thammass/uno_Personal_door/1379958241-systemsafe-o.jpg

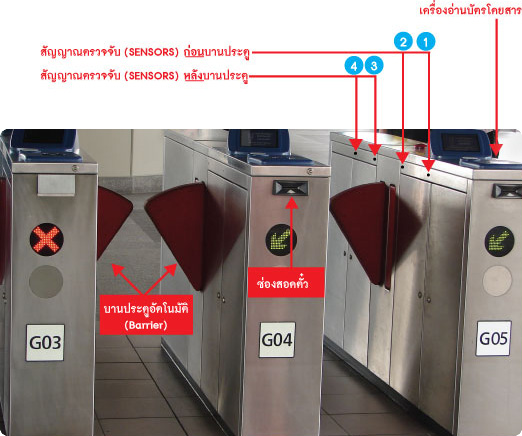
1379958241-systemsafe-o.jpg
