thammass/uno_Personal_door/Feedback_LDR.pptx

ติดตั้งแบบที่1 เจาะรู 3ｍｍ

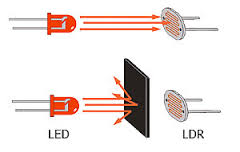
[picture p2: figure]

บานประตู

3mm

0 องศา

180 องศา

Center

การ feed back ตำแหน่งองศาประตู

ติดตั้งแบบที่2 ไม่ต้องเจาะรู

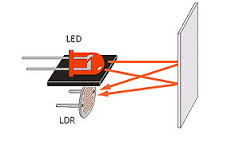
[picture p3: figure]
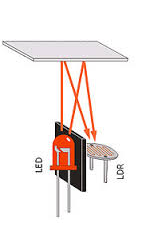
[picture p4: figure]

2015/08/25
