thammass/uno_Personal_door/Feedback_Proximity_degree.pptx

การ feed back ตำแหน่งองศาประตู
ด้วย Proximity Switch

ติดตั้งแนวตั้ง

180 องศา

บานประตู

5mm

0 องศา

ติดตั้งแนวนอน

Center

2015/08/28

## Slide 2

เข้า

ช่องทางเดินที่ 1

ออก

เข้า

ช่องทางเดินที่ 2

ออก

ช่องทางเดินที่ 3

## Slide 3

เข้า

ช่องทางเดินที่ 1

ออก

เข้า

ช่องทางเดินที่ 2

ออก

ช่องทางเดินที่ 3

## Slide 4

รปภ

90 องศา

เข้า

ช่องทางเดินที่ 1

S1

F1

1

S2

F2

0 องศา

S4

0 องศา

ออก

180 องศา

2

180 องศา

เข้า

0 องศา

S3

นอกโรงงาน

90 องศา

ช่องทางเดินที่ 2

90 องศา

F4

3

F3

0 องศา

S6

4

S5

ออก

ช่องทางเดินที่ 3

90 องศา

## วิเคราะห์การหมุน 0 – 90 องศา

TAG

90

0

แก้ไขบานอยู่ไม่ตรง 90 องศา ตอนเริ่มต้น

เปิด: slow จนไม่เจอ TAG -> Feed Step -> Wait

TAG

90

0

ปิด: Feed Step -> slow จนเจอ Tag -> stop
“แก้ปัญหาองศาผิด ขณะ Feed Step เจอ Tag ให้ Stop เลย”

ปรับให้ตรง 90 องศา

## วิเคราะห์การหมุน 90 – 180 องศา

180

90

TAG

แก้ไขบานอยู่ไม่ตรง 90 องศาตอนเริ่มต้น

เปิด: slow จนเจอ TAG -> Feed Step -> Wait

TAG

180

90

ปิด: Feed Step -> slow จนไม่เจอ Tag -> stop
“แก้ปัญหาองศาผิด ขณะ Feed step ไม่เจอ Tag ให้ Stop เลย”

ปรับให้ตรง 90 องศา

## Slide 7

รปภ

90 องศา

1

90

0

2

90

0

180

นอกโรงงาน

3

90

0

180

4

90

0

เข้า

0 องศา

ช่องที่ 1

S1

F1

1

S2

F2

S4

0 องศา

ออก

180 องศา

2

180 องศา

เข้า

0 องศา

S3

90 องศา

ช่องที่ 2

90 องศา

F4

3

F3

0 องศา

S6

4

S5

ออก

ช่องที่ 3

90 องศา

## Slide 8

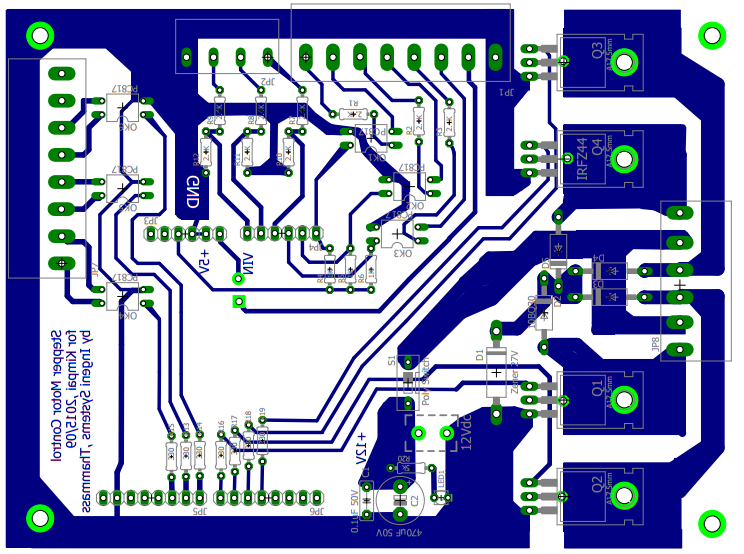
[picture p5: figure]

ลายวงจร จากมุมมอง TOP

## Slide 9

การต่อสาย control ชุด Stepper Motor Control

TAG
+: 24V
- : 0V

DIR(n)
5V:180องศา
0V: 0องศา

OPEN(n)
5V: DIR
0V: 90องศา

ไฟเลี้ยงบอร์ด UNO
5VDC 300mA

ไม่ได้ใช้งาน

+ -

+ -

+ -

+ -

ไม่ได้ใช้งาน

+V

A+

B+

A-

+V

B-

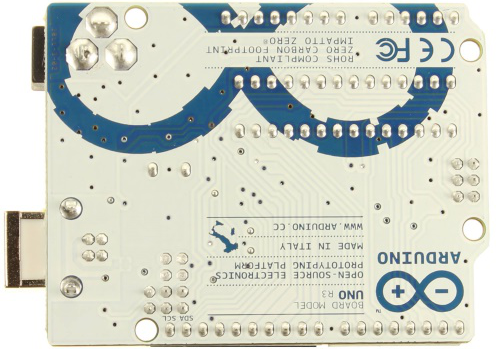
[picture p6: figure]

+ -

Stepper motor
1.8องศา / Step , 3A

M

A+
+V
A-
B+
+V
B-

แสดงสถานะไฟจ่ายให้มอเตอร์

ไฟเลี้ยงเฉพาะมอเตอร์
5V –> 12V ( +V )

Poly Switch 6A
( ตัดไฟเมื่อ Over Load )

## Slide 10

การต่อสาย Sensor Control (Common GND)

Input

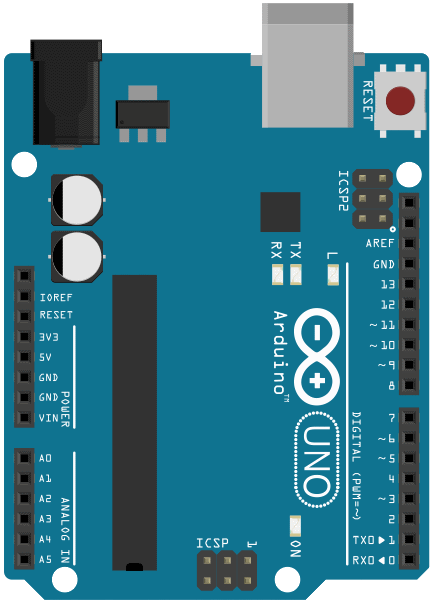
[picture p7: figure]

Output

- Active : ป้อน 0V (Short GND)

5VDC

S6_Echo

S6_Trig

GND

DIR3

DIR2

OPEN4

S4_Echo

S4_Trig

OPEN2

F3

S3_Echo

S3_Trig

F2

S2_Echo

S2_Trig

OPEN1

ไม่ใช้งาน

OPEN3

F4

F1

## Slide 11

F4

F3

F2

F1

System Diagram – สัญญาณควบคุม

S2

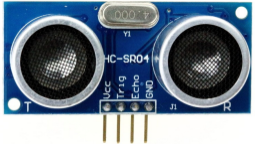
[picture p8: figure]

S3

ไม่ได้ใช้งาน

+ -

+ -

+ -

+ -

ไม่ได้ใช้งาน

+V

A+

B+

A-

+V

B-

+ -

Door1-DIR0

ไม่ได้ใช้งาน

+ -

+ -

+ -

+ -

ไม่ได้ใช้งาน

+V

A+

B+

A-

+V

B-

+ -

Door2-DIR1

ไม่ได้ใช้งาน

+ -

+ -

+ -

+ -

ไม่ได้ใช้งาน

+V

A+

B+

A-

+V

B-

+ -

Door3-DIR1

S4

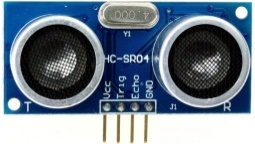
[picture p9: figure]

S6

ไม่ได้ใช้งาน

+ -

+ -

+ -

+ -

ไม่ได้ใช้งาน

+V

A+

B+

A-

+V

B-

+ -

Door2-DIR0

## Slide 12

1. แก้ไขปัญหาการตรวจจับองศาผิด ในกรณีบานเปิด ไปที่ 0 องศา แล้วเจอ tag

องศา
TAG

0

180

90

2. แก้ไขปัญหาการตรวจจับ Center ผิดตำแหน่ง
การตรวจสอบจะทำงานควบคู่กับ Tag องศา
เพื่อกำหนดทิศทางของในการเคลื่อนที่ไปตำแหน่ง
center ที่ถูกต้อง

แบบเดิม

Center
TAG

แบบเดิม

TAG

แบบใหม่

แบบใหม่-1

Center
TAG

แบบใหม่-2

Center
TAG
