thammass/uno_Personal_door/Door_Map-r2.JPG

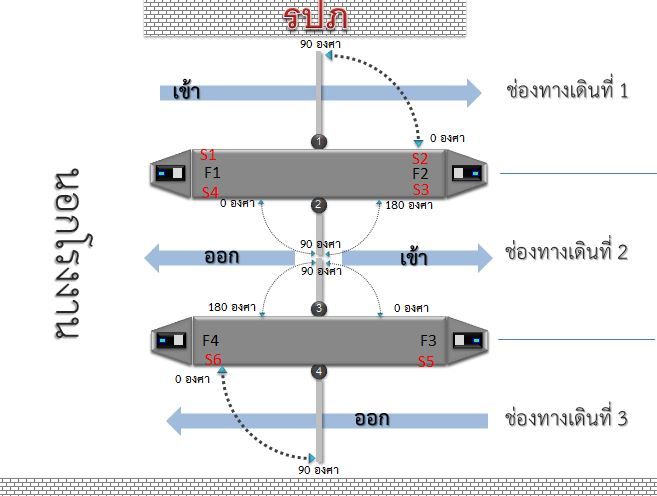
Door_Map-r2.JPG
