thammass/uno_Personal_door/Feedback_Proximity_degree/Slide1.JPG

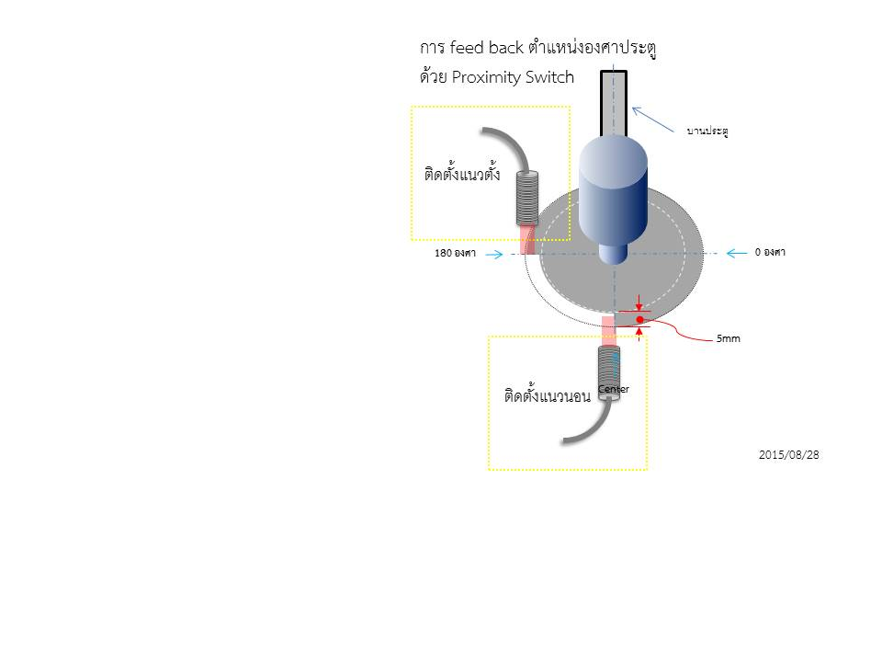
Feedback_Proximity_degree/Slide1.JPG
