thammass/uno_Personal_door/Feedback_Proximity_degree/Slide2.JPG

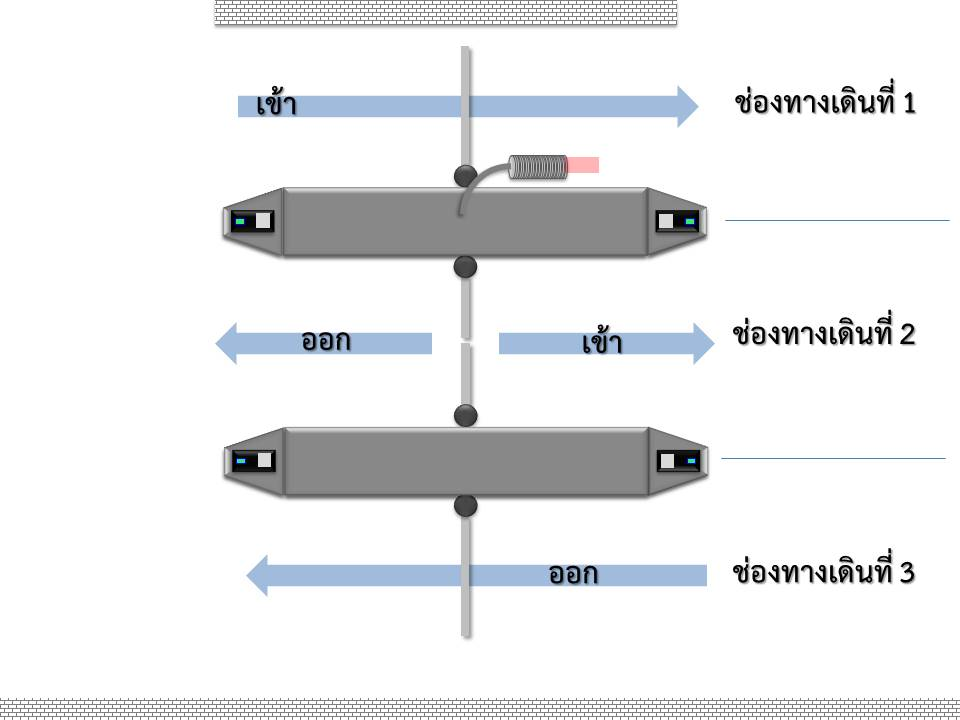
Feedback_Proximity_degree/Slide2.JPG
