thammass/uno_Personal_door/Feedback_Proximity_degree/Slide4.JPG

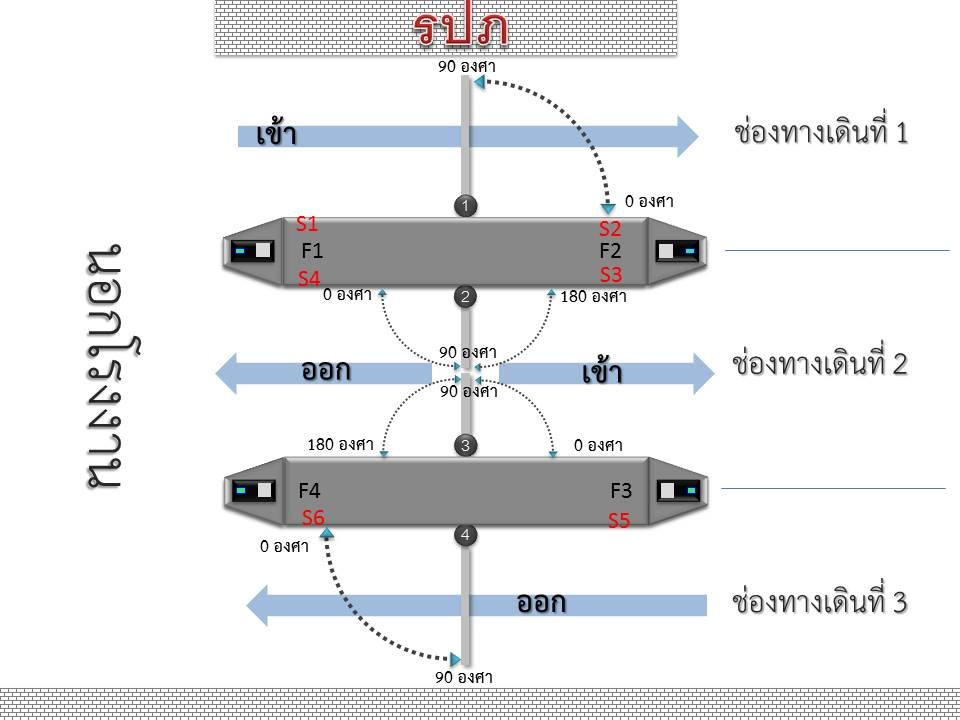
Feedback_Proximity_degree/Slide4.JPG
