thammass/uno_Personal_door/Feedback_Proximity_degree/Slide5.JPG

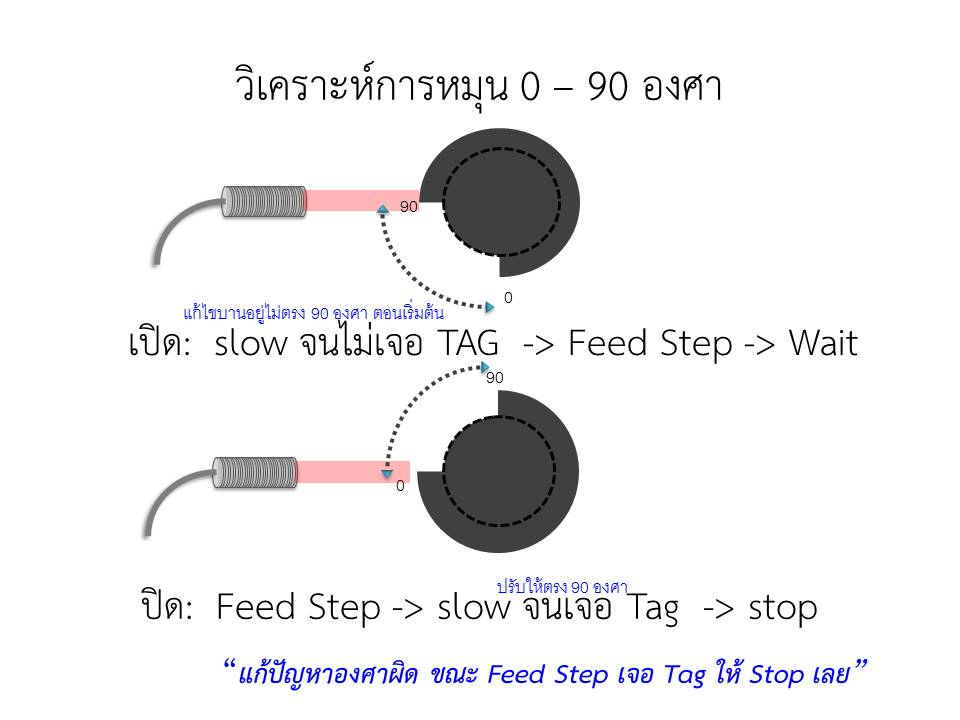
Feedback_Proximity_degree/Slide5.JPG
