thammass/uno_Personal_door/Feedback_Proximity_degree/Slide6.JPG

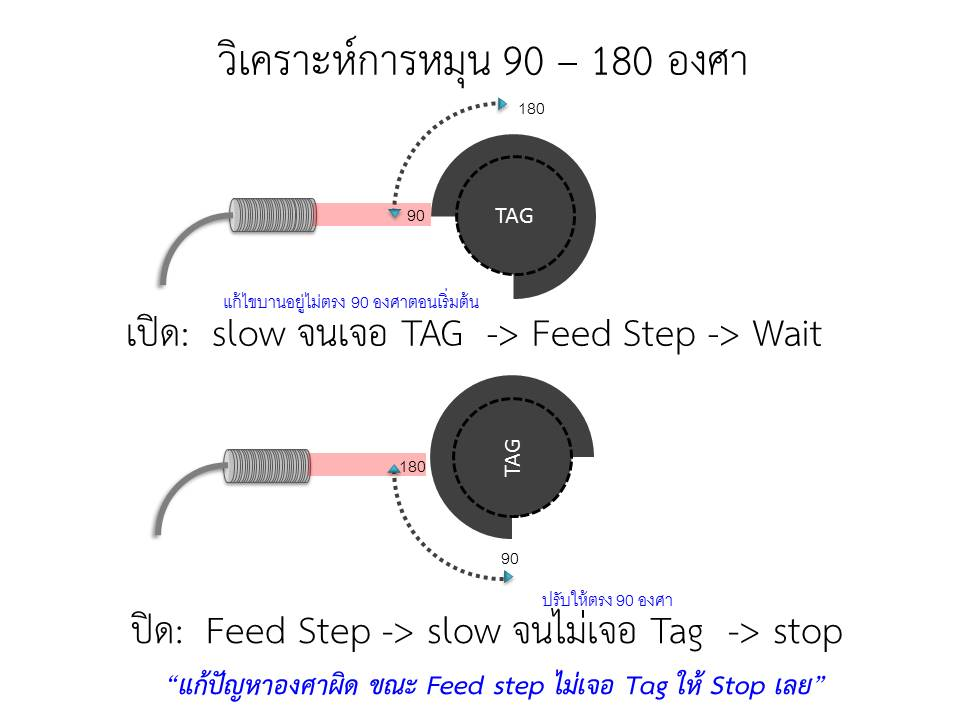
Feedback_Proximity_degree/Slide6.JPG
