thammass/uno_Personal_door/Feedback_Proximity_degree/Slide7.JPG

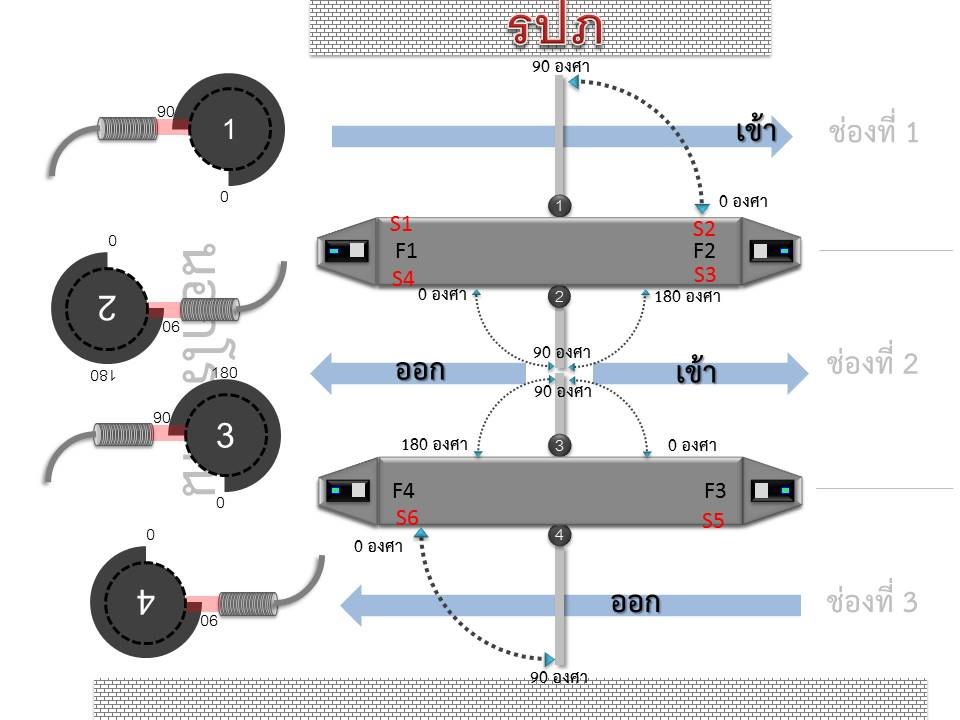
Feedback_Proximity_degree/Slide7.JPG
