thammass/uno_Personal_door/StepperMotor-R1.JPG

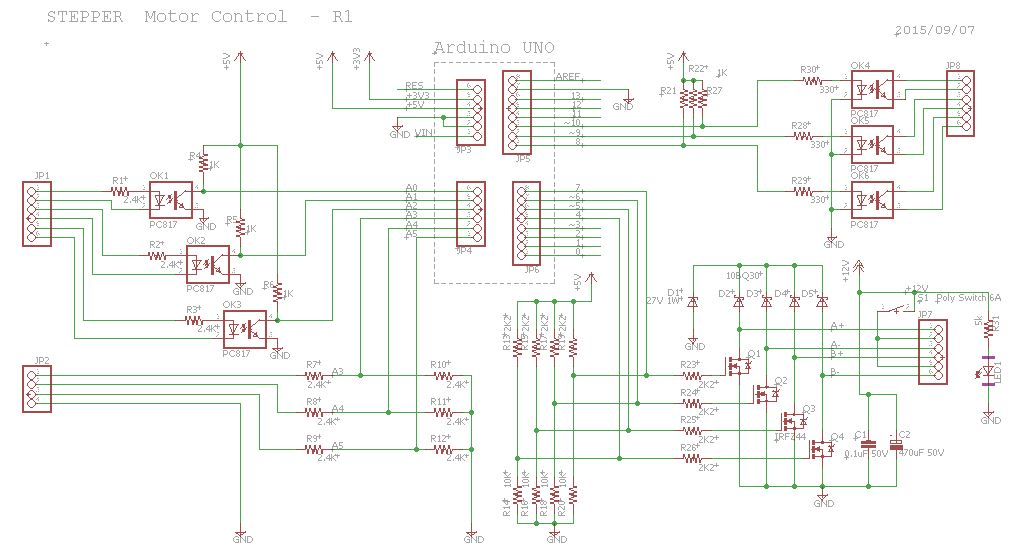
StepperMotor-R1.JPG
